griffblob/EEE3088-69/EEE3088 Sensing/readme.md

# Sensing Subsystem
This subsystem was designed by TRCGRI001 and is they eyes of our robot

Here you will find the KICAD project files. 

🍑
