griffblob/EEE3088-69/Reports/README.md

# Reports go here
Reports will only be put here after final submission. 
So no one does a bad. 🕵️
