griffblob/EEE3088-69/EEE3088 Sensing/jlcpcb/production_files/EEE3088F_Project_JLCPCBBOM_TRCGRI001.png

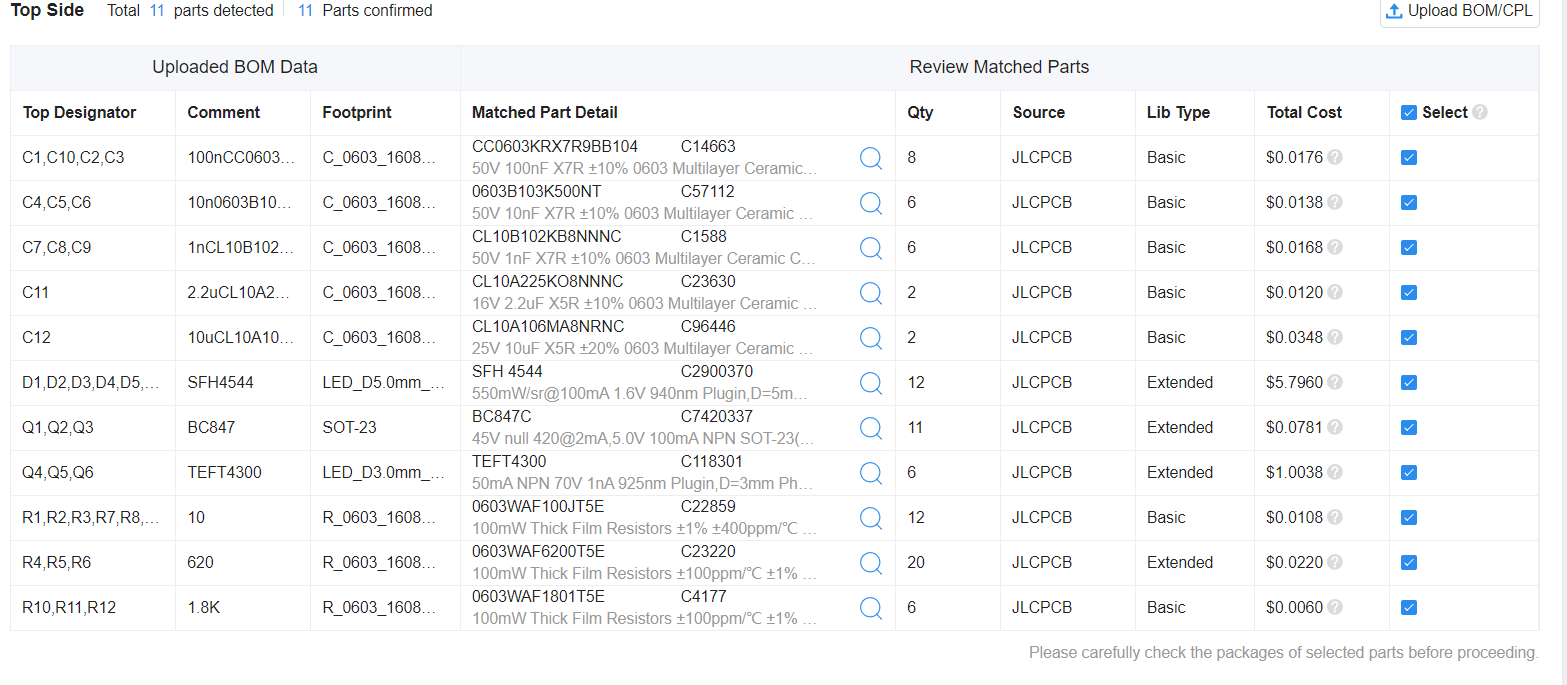
EEE3088 Sensing/jlcpcb/production_files/EEE3088F_Project_JLCPCBBOM_TRCGRI001.png
