griffblob/EEE3088-69/EEE3088 Sensing/jlcpcb/Screenshot 2024-03-23 191323.png

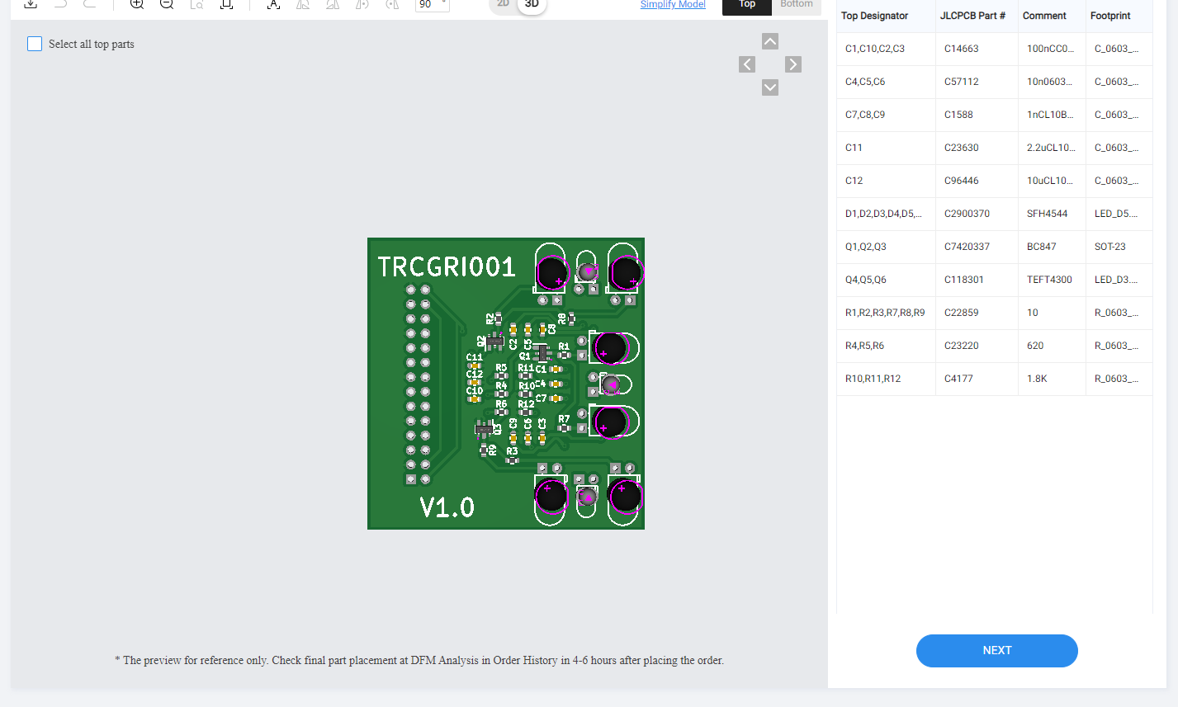
EEE3088 Sensing/jlcpcb/Screenshot 2024-03-23 191323.png
