griffblob/EEE3088-69/EEE3088F Power/PowerSubsystem/PowerSubsystem.pdf

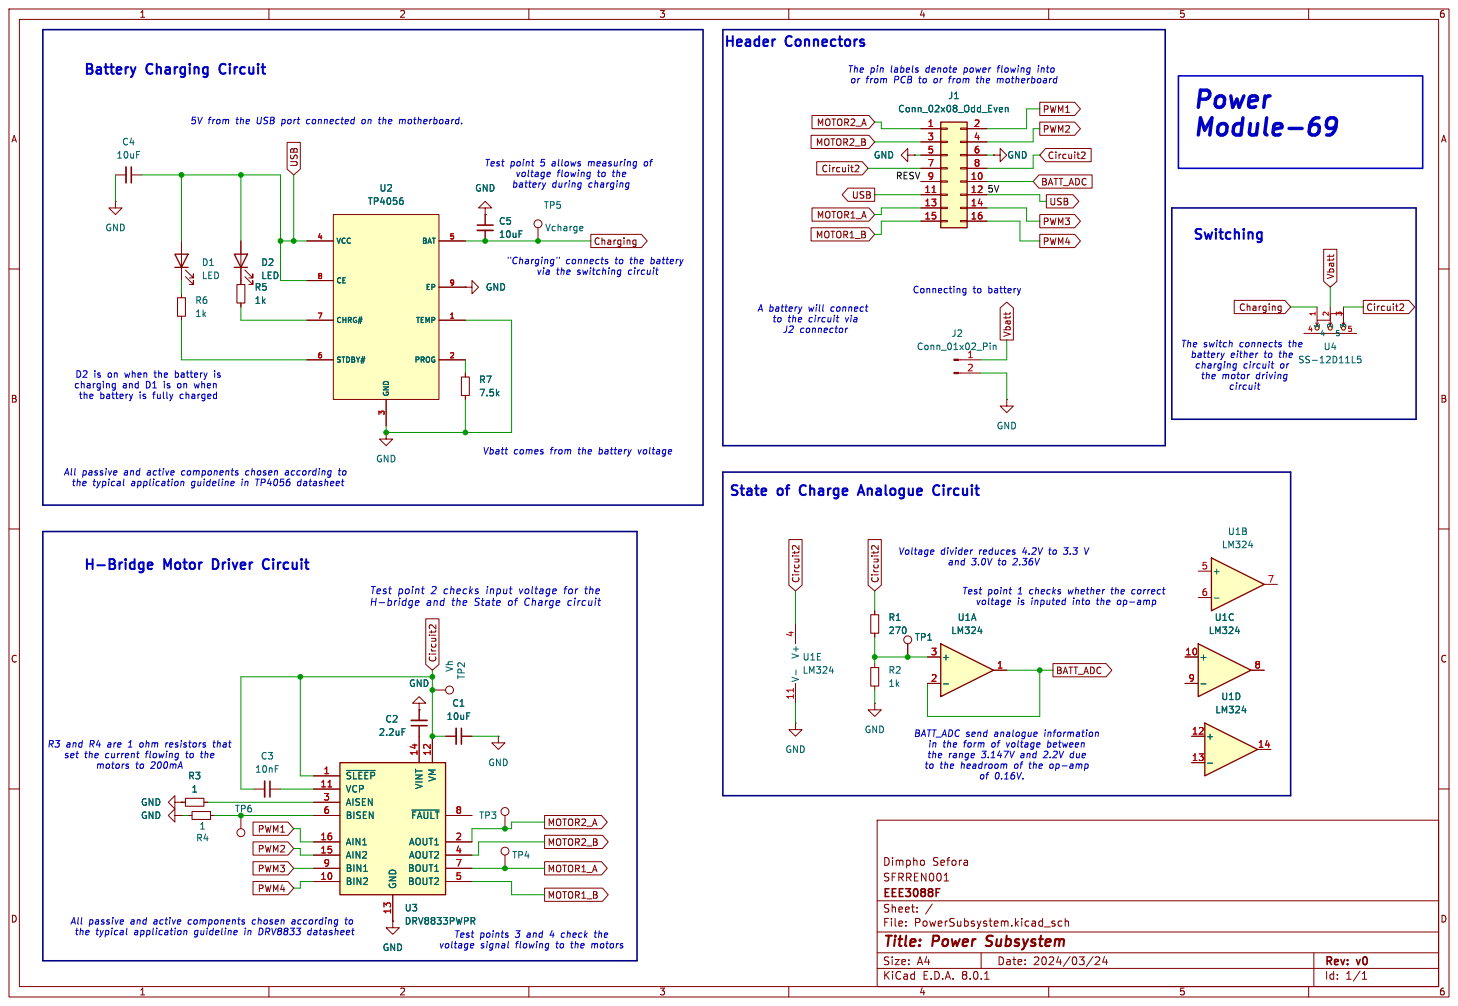
[picture p4: page 1]

The pin labels denote power flowing into

3 VCC 4 BAT 5 STDBY# 6 CHRG# 7 CE 8 EP 9 U2 TP4056 R7

3 VCC 4 BAT 5 STDBY# 6 CHRG# 7 CE 8 EP 9 R7

A battery will connect
to the circuit via
J2 connector State of Charge Analogue Circuit

battery either to the
the motor driving

circuit Voltage divider reduces 4.2V to 3.3 V

in the form of voltage between
the range 3.147V and 2.2V due
to the headroom of the op-amp

File: PowerSubsystem.kicad_sch Sheet: / EEE3088F SFRREN001 Dimpho Sefora GND

Id: 1/1 Title: Power Subsystem

Test points 3 and 4 check the
voltage signal flowing to the motors
