griffblob/EEE3088-69/EEE3088F Power/PowerSubsystem/PowerSubsystem.kicad_pcb

## KiCad design EEE3088F Power/PowerSubsystem/PowerSubsystem.kicad_pcb (2024-05-17)

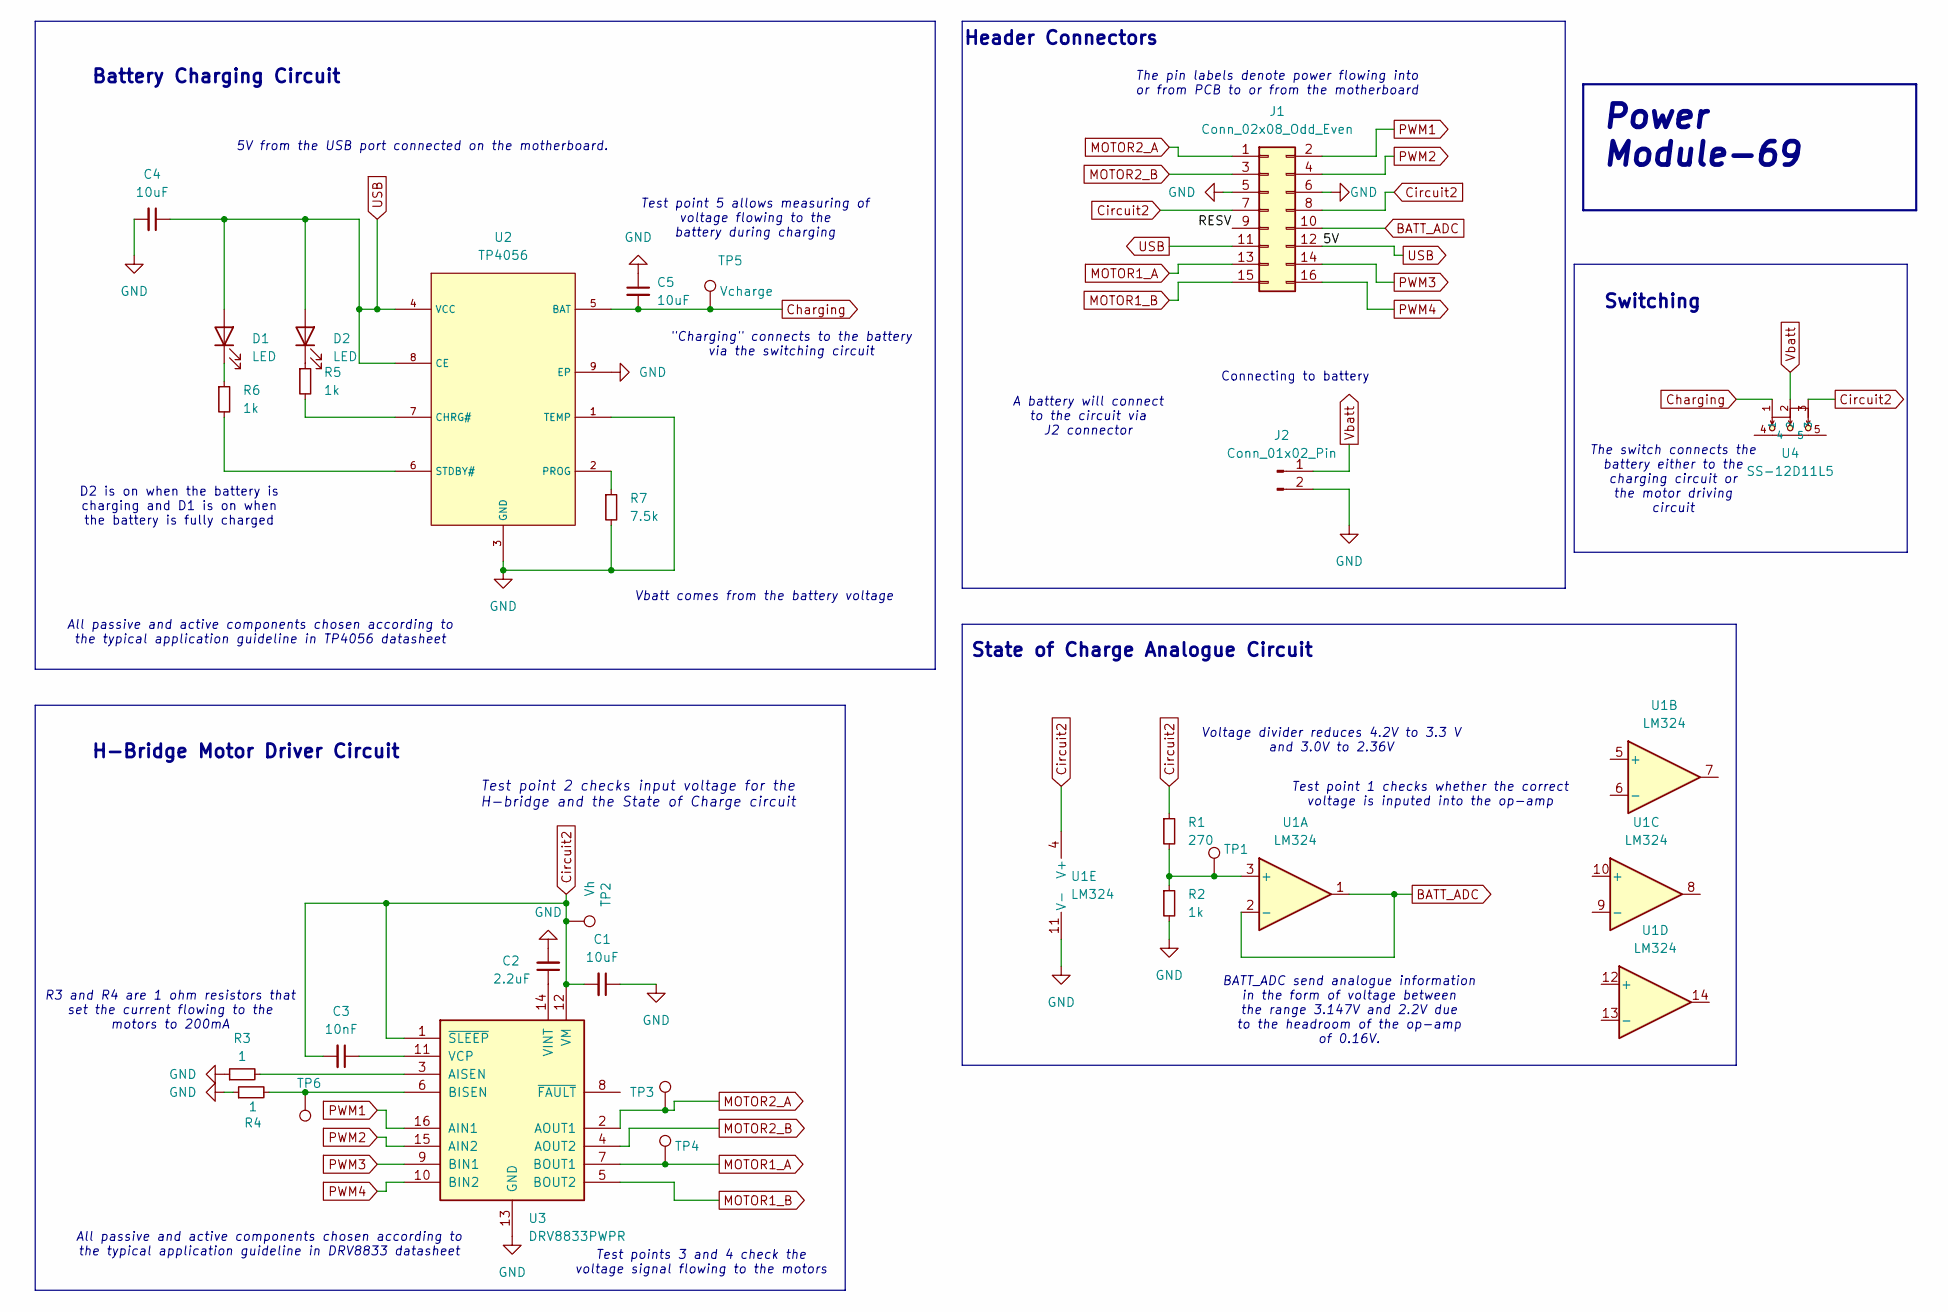
[picture p5: schematic PowerSubsystem.kicad_sch, Power Subsystem]

Parts:
C1, C4, C5: 10uF; C_0603_1608Metric; LCSC C19702
C2: 2.2uF; C_0603_1608Metric; LCSC C23630
C3: 10nF; C_0603_1608Metric; LCSC C57112
D1: LED; LED_0603_1608Metric; LCSC C2290
D2: LED; LED_0603_1608Metric; LCSC C2286
J1: Conn_02x08_Odd_Even; PinHeader_2x08_P2.54mm_Vertical
J2: Conn_01x02_Pin; JST_PH_B2B-PH-K_1x02_P2.00mm_Vertical
R1: 270; R_0603_1608Metric; LCSC C22966
R2, R5, R6: 1k; R_0603_1608Metric; LCSC C21190
R3, R4: 1; R_0603_1608Metric; LCSC C22936
R7: 7.5k; R_0603_1608Metric; LCSC C4211
TP1: Vadc; TestPoint_Pad_1.0x1.0mm
TP2: Vh; TestPoint_Pad_1.0x1.0mm
TP3: Vm1; TestPoint_Pad_1.0x1.0mm
TP4: Vm2; TestPoint_Pad_1.0x1.0mm
TP5: Vcharge; TestPoint_Pad_1.0x1.0mm
TP6: TestPoint; TestPoint_Pad_1.0x1.0mm
U1: LM324
U2: TP4056; ESOP-8_L4.9-W3.9-P1.27-LS6.0-BL-EP; LCSC C16581
U3: DRV8833PWPR; TSSOP-16-1EP_4.4x5mm_P0.65mm; LCSC C50506
U4: SS-12D11L5; SW-TH_SS-12D11L5; LCSC C319010

Connections:
/RESV: J1.9
BATT_ADC: J1.10, U1.1, U1.2 (-)
Charging: C5.2, TP5.1, U2.5 (BAT), U4.1
Circuit2: C1.2, C3.2, J1.7, J1.8, R1.1, TP2.1, U1.4 (V+), U3.1 (~SLEEP), U3.12 (VM), U4.3
GND: C1.1, C2.2, C4.2, C5.1, J1.5, J1.6, J2.2, R2.2, R3.1, R4.1, R7.2, U1.11 (V-), U2.1 (TEMP), U2.3 (GND), U2.9 (EP), U3.13 (GND), U3.17 (GND)
MOTOR1_A: J1.13, TP4.1, U3.7 (BOUT1)
MOTOR1_B: J1.15, U3.5 (BOUT2)
MOTOR2_A: J1.1, TP3.1, U3.2 (AOUT1)
MOTOR2_B: J1.3, U3.4 (AOUT2)
unnamed: D1.1 (K), R6.1
unnamed: D2.1 (K), R5.1
unnamed: R1.2, R2.1, TP1.1, U1.3 (+)
unnamed: R5.2, U2.7 (CHRG#)
unnamed: R7.1, U2.2 (PROG)
unnamed: R6.2, U2.6 (STDBY#)
unnamed: R3.2, U3.3 (AISEN)
unnamed: R4.2, TP6.1, U3.6 (BISEN)
unnamed: C3.1, U3.11 (VCP)
unnamed: C2.1, U3.14 (VINT)
PWM1: J1.2, U3.16 (AIN1)
PWM2: J1.4, U3.15 (AIN2)
PWM3: J1.14, U3.9 (BIN1)
PWM4: J1.16, U3.10 (BIN2)
USB: C4.1, D1.2 (A), D2.2 (A), J1.11, J1.12, U2.4 (VCC), U2.8 (CE)
Vbatt: J2.1, U4.2

Notes on the sheet:
Battery Charging Circuit
H-Bridge Motor Driver Circuit
Power Module-69
Switching
BATT_ADC send analogue information in the form of voltage between the range 3.147V and 2.2V due to the headroom of the op-amp of 0.16V.
Test point 1 checks whether the correct voltage is inputed into the op-amp
All passive and active components chosen according to the typical application guideline in DRV8833 datasheet
The switch connects the battery either to the charging circuit or the motor driving circuit
Test point 2 checks input voltage for the H-bridge and the State of Charge circuit
All passive and active components chosen according to the typical application guideline in TP4056 datasheet
Connecting to battery
5V from the USB port connected on the motherboard.
Test points 3 and 4 check the voltage signal flowing to the motors
Header Connectors
Voltage divider reduces 4.2V to 3.3 V and 3.0V to 2.36V
"Charging" connects to the battery via the switching circuit
A battery will connect to the circuit via J2 connector
D2 is on when the battery is charging and D1 is on when the battery is fully charged
R3 and R4 are 1 ohm resistors that set the current flowing to the motors to 200mA
Test point 5 allows measuring of voltage flowing to the battery during charging
State of Charge Analogue Circuit
Vbatt comes from the battery voltage
The pin labels denote power flowing into or from PCB to or from the motherboard

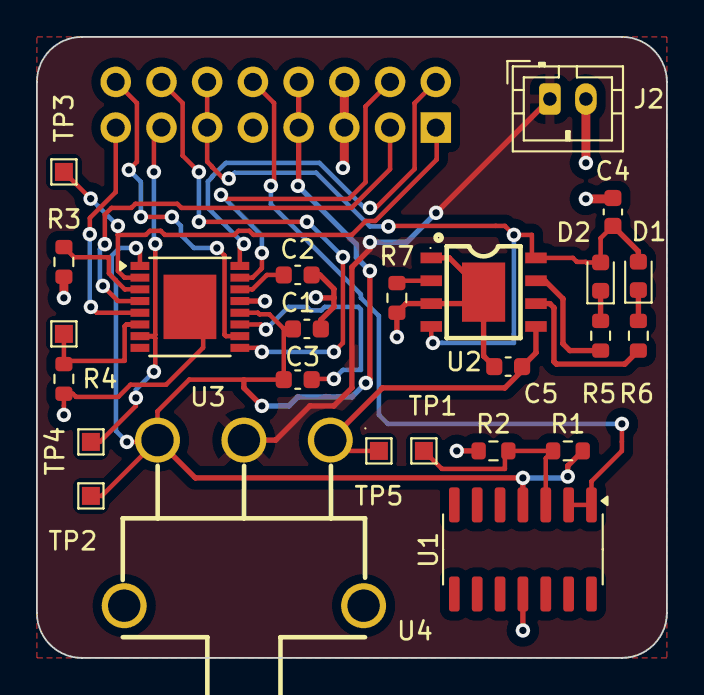
[picture p6: board PowerSubsystem.kicad_pcb from above]

Board: 2 copper layers, 35.0 x 34.5 mm, 26 parts (1 on the bottom side), 24 nets.
