griffblob/EEE3088-69/EEE3088 Sensing/EEE3088 Sensing.kicad_pcb

## KiCad design EEE3088 Sensing/EEE3088 Sensing.kicad_pcb (2024-04-21)

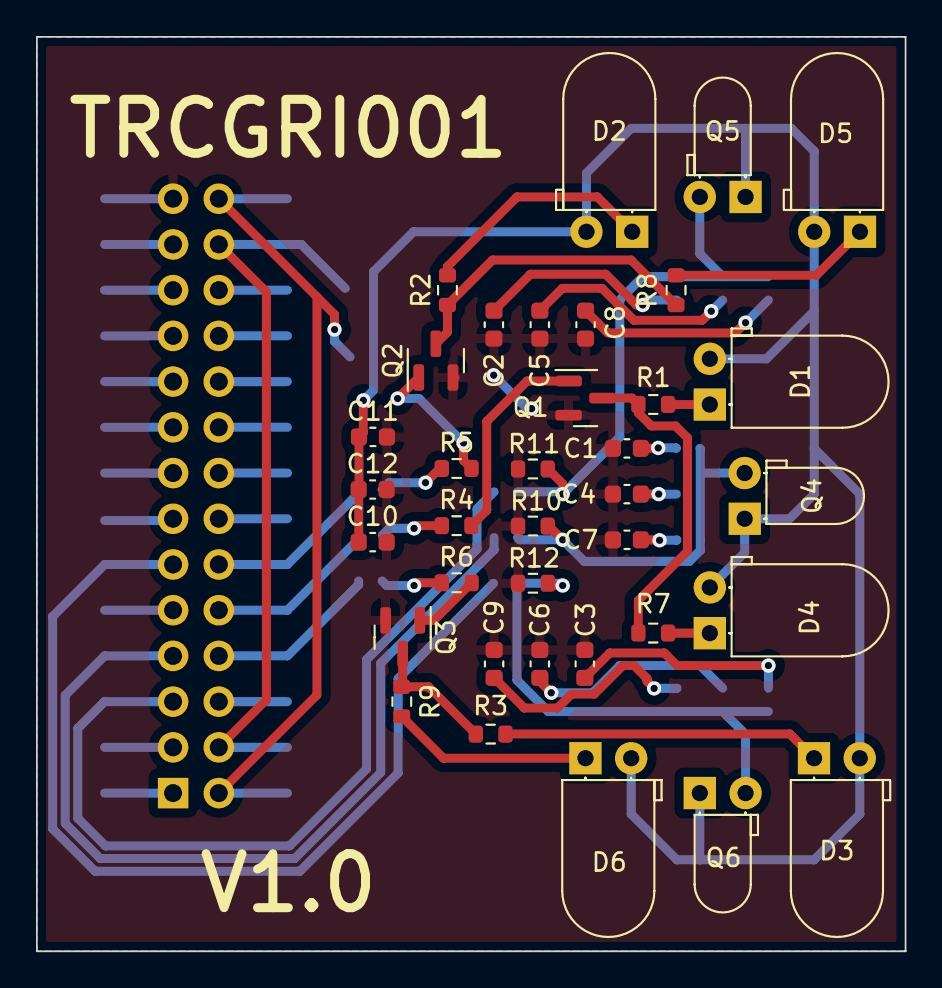
[picture p7: board EEE3088 Sensing.kicad_pcb from above]

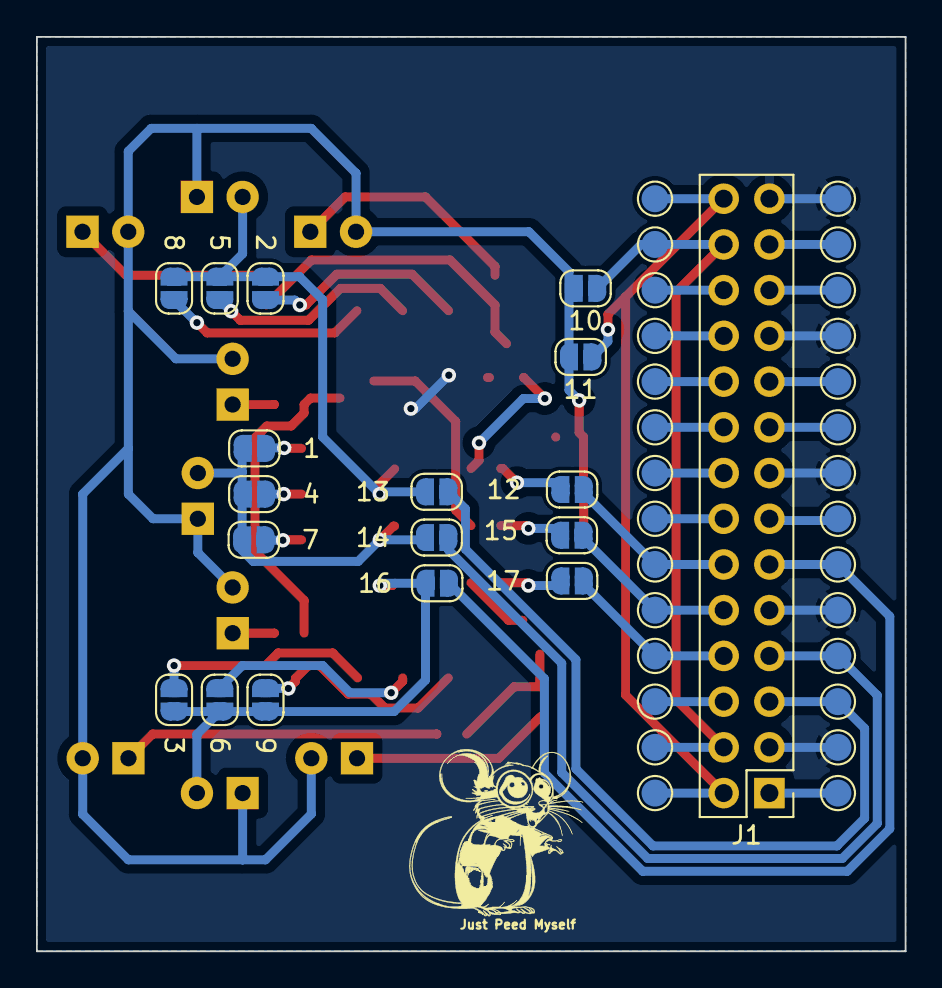
[picture p8: board EEE3088 Sensing.kicad_pcb from below]

Board: 2 copper layers, 48.3 x 50.8 mm, 82 parts (46 on the bottom side), 50 nets.

Parts:
1, 2, 3, 4, 5, 6, 7, 8, 9, 10, 11, 12, 13, 14, 15, 16, 17: SolderJumper_2_Open; SolderJumper-2_P1.3mm_Open_RoundedPad1.0x1.5mm
C1, C2, C3, C10: 100n CC0603KRX7R9BB104; C_0603_1608Metric
C4, C5, C6: 10n 0603B103K500NT; C_0603_1608Metric
C7, C8, C9: 1n CL10B102KB8NNNC; C_0603_1608Metric
C11: 2.2u CL10A225KO8NNNC; C_0603_1608Metric
C12: 10u CL10A106MA8NRNC; C_0603_1608Metric
D1, D2, D3, D4, D5, D6: SFH 4544; LED_D5.0mm_Horizontal_O1.27mm_Z3.0mm_IRBlack
J1: Conn_02x14_Odd_Even; PinHeader_2x14_P2.54mm_Vertical
Q1, Q2, Q3: BC847; SOT-23
Q4, Q5, Q6: TEFT4300; LED_D3.0mm_Horizontal_O1.27mm_Z2.0mm_IRBlack
R1, R2, R3, R7, R8, R9: 10; R_0603_1608Metric
R4, R5, R6: 620; R_0603_1608Metric
R10, R11, R12: 1.8K; R_0603_1608Metric
TP1, TP2, TP3, TP4, TP5, TP6, TP7, TP8, TP9, TP10, TP11, TP12, TP13, TP14, TP15, TP16, TP17, TP18, TP19, TP20, TP21, TP22, TP23, TP24, TP25, TP26, TP27, TP28: TestPoint; TestPoint_Pad_D1.5mm

Connections:
3V3: 11.1 (A), J1.2, J1.28, TP15.1, TP28.1
AB0: J1.25, TP13.1
BATT: 10.1 (A), J1.4, J1.26, TP16.1, TP27.1
GND: C1.2, C2.2, C3.2, C4.2, C5.2, C6.2, C7.2, C8.2, C9.2, C10.2, C11.2, C12.2, J1.3, J1.9, J1.15, J1.21, J1.27, Q1.2 (E), Q2.2 (E), Q3.2 (E), R10.2, R11.2, R12.2, TP2.1, TP5.1, TP8.1, TP11.1, TP14.1
unnamed: 1.1 (A), C1.1
unnamed: 2.1 (A), C2.1
unnamed: 3.1 (A), C3.1
unnamed: 4.1 (A), C4.1
unnamed: 5.1 (A), C5.1
unnamed: 6.1 (A), C6.1
unnamed: 7.1 (A), C7.1
unnamed: 8.1 (A), C8.1
unnamed: 9.1 (A), C9.1
unnamed: D1.1 (K), R1.1
unnamed: D2.1 (K), R2.1
unnamed: D3.1 (K), R3.1
unnamed: D4.1 (K), R7.1
unnamed: D5.1 (K), R8.1
unnamed: D6.1 (K), R9.1
unnamed: Q1.1 (B), R4.2
unnamed: Q1.3 (C), R1.2, R7.2
unnamed: Q2.1 (B), R5.2
unnamed: Q2.3 (C), R2.2, R8.2
unnamed: Q3.1 (B), R6.2
unnamed: Q3.3 (C), R3.2, R9.2
PA3: 13.1 (A), J1.5, TP3.1
PA4: 14.1 (A), J1.7, TP4.1
PA5: 16.1 (A), J1.11, TP6.1
PA6: J1.13, TP7.1
PA7: J1.17, TP9.1
PC4: J1.19, TP10.1
PC5: J1.23, TP12.1
PE8: J1.22, TP25.1
PE9: J1.20, TP24.1
PE10: J1.18, TP23.1
PE11: J1.16, TP22.1
PE12: J1.14, TP21.1
PE13: 12.1 (A), J1.12, TP20.1
PE14: 15.1 (A), J1.10, TP19.1
PE15: 17.1 (A), J1.8, TP18.1
RESV1: J1.24, TP26.1
RESV2: J1.6, TP17.1
RESV3: J1.1, TP1.1
VinL: 12.2 (B), R5.1
VinM: 15.2 (B), R4.1
VinR: 17.2 (B), R6.1
VoutL: 2.2 (B), 5.2 (B), 8.2 (B), 13.2 (B), Q5.2 (E), R11.1
VoutM: 1.2 (B), 4.2 (B), 7.2 (B), 14.2 (B), Q4.2 (E), R10.1
VoutR: 3.2 (B), 6.2 (B), 9.2 (B), 16.2 (B), Q6.2 (E), R12.1
vcc: 10.2 (B), 11.2 (B), C10.1, C11.1, C12.1, D1.2 (A), D2.2 (A), D3.2 (A), D4.2 (A), D5.2 (A), D6.2 (A), Q4.1 (C), Q5.1 (C), Q6.1 (C)
