griffblob/EEE3088-69/(commit log)

2024-04-21 Added Sensing Files
    Added KICAD Sensing Files
    [BOM-EEE3088 Sensing.csv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]
2024-04-22 Added power files.
    [BOM-PowerSubsystem2.csv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]
